Hootie81/Power-Shield/Power Shield v1-0/PowerShield v1-0 BOM.xlsx

Hootie81's Power Shield
Version 1.0
2014-08-02
Description | Qty | Value | Package | Designator | Manufacturer | Part Number
PCB | 1 | V1.0 | NA | NA | OSH Park | NA
Diode Schottky | 2 | 30v 2A | DO-214AC | D1, D2 | Diodes inc | B230A-13-F
Inductor | 1 | 47uH | Non Standard | L1 | Bourns inc | SDR1005-470KL
Capacitor Aluminum | 1 | 100uf 35v | Radial Can, SMD | C2 | Panasonic | EEE-1AA101SP
Capacitor Aluminum | 1 | 47uF 35v | Radial Can, SMD | C1 | Panasonic | EEE-1EA470WP
IC REG BUCK | 1 | 5V 2A | 8SOIC | U1 | Diodes Inc | AP1509-50SG-13
Capacitor | 1 | 10nf, 10v, 10% | 603 | C3 | AVX Corp | 0603ZC103KAT2A
Resistor | 1 | 1K 0.25W 5% | 603 | R1 | Rohm Semiconductor | ESR03EZPJ102
Terminal Block | 1 | NA | NA | X1 | Phoenix Contact | 1751248
SIL Vert Pin header | 1 | 2 pin | NA 0.100" | JP1 | Harwin Inc | M20-9990246
LED blue | 1 | 3.4v 20mA | 603 | D3 | Lite-on Inc | LTST-C191TBKT
