Hootie81/Power-Shield/Power Shield v1-0/PowerShield v1-0.brd

## EAGLE design Power Shield v1-0/PowerShield v1-0.brd (2014-07-28)

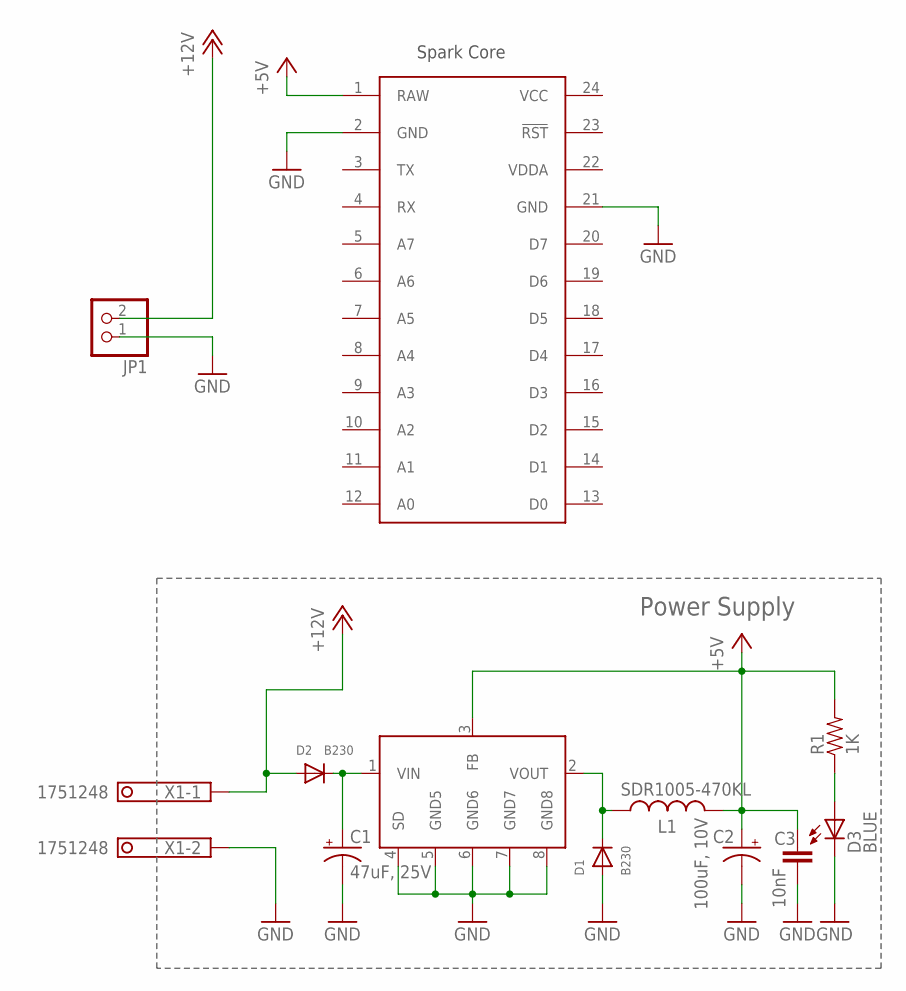
[picture p1: schematic PowerShield v1-0.sch]

Parts:
C1: 47uF, 25V; PANASONIC_D
C2: 100uF, 10V; PANASONIC_D
C3: 10nF; 0603-CAP
D1, D2: B230; SMADIODE
D3: BLUE; LED-0603
JP1: PINHD-1X2; 1X02
L1: SDR1005-470KL; INDUCTOR-SDR1005-470KL
R1: 1K; 0603-RES
U1: AP1509-50SG-13; SO08
U$2: SPARK_CORECORE; SPARK_CORE
X1: 1751248

Connections:
+5V: C2.+, C3.2, L1.P$2 (2), R1.2, U1.3 (FB), U$2.1 (RAW)
+12V: D2.A, JP1.2, X1.1
GND: C1.-, C2.-, C3.1, D1.A, D3.C, JP1.1, U1.4 (SD), U1.5 (GND5), U1.6 (GND6), U1.7 (GND7), U1.8 (GND8), U$2.2 (GND), U$2.21 (GND), X1.2
unnamed: D3.A, R1.1
unnamed: C1.+, D2.C, U1.1 (VIN)
unnamed: D1.C, L1.P$1 (1), U1.2 (VOUT)
VCC: U$2.24 (VCC)
VDDA: U$2.22 (VDDA)

Notes on the sheet:
Power Supply
Spark Core

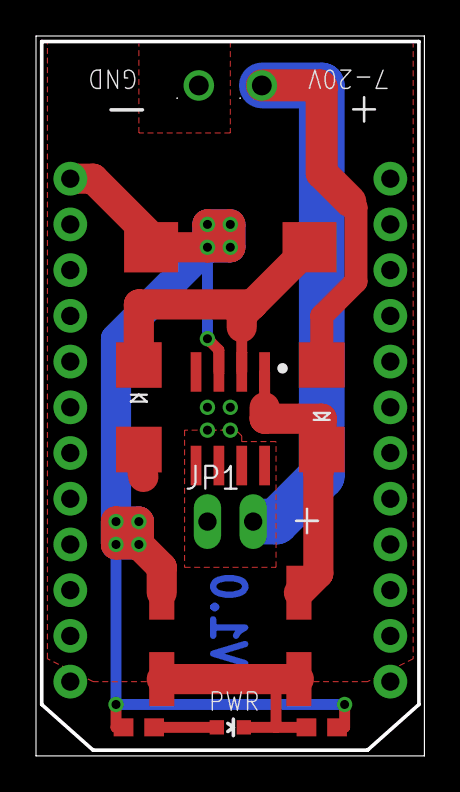
[picture p2: board PowerShield v1-0.brd from above]

Board: 2 copper layers, 21.6 x 40.0 mm, 12 parts (0 on the bottom side), 6 nets.
