Hootie81/Power-Shield/(commit log)

2014-07-26 5v Power supply board for Spark Core
    A power supply board for the spark core with a wide input voltage range
    of 7v to 22v, the footprint is similar to the Spark slightly longer for
    access to input terminal. I supplies a regulated 5v output at up to 2A
    for driving the spark and other devices.
    A header included near the centre of the board passes the input power to
    other boards that require the higher voltage
    [PowerShield.brd, PowerShield.sch]
2014-07-28 Fixed silkscreen
    Fixed silkscreen
    Added Gerbers
    [PowerShield v1-0.brd, PowerShield v1-0.sch]
2014-08-02 Added BOM
    [PowerShield v1-0 BOM.xlsx]
2014-09-12 Cleanup
    Removed old versions to avoid confusion
    [PowerShield.brd, PowerShield.sch]
